Mipot-Hi-Tech/mip_servo_controller/production/BOM_PCBWay.xlsx

 |  |  | LoRa based triple stepper board PCS BOM
Item # | *Designator | *Qty | Manufacturer | *Mfg Part # | Description / Value | *Package/Footprint | Type | ORDER CODE(MOUSER)
1 | C1,C17,C32,C47,C53,C57,C67 | 7 | MURATA | GRM21BR71C475KE51L | Multilayer Ceramic Capacitors MLCC - SMD/SMT 4.7 uF 16 VDC 10% 0805 X7R | C0805 | SMD | 81-GRM21BR71C475KE1L
2 | C2,C3,C6,C7,C19,C21,C22,C34,C36,C37,C49,C50,C51,C52,C55,C58,C59,C60,C61,C63,C64,C65,C68,C69,C70,C71,C72,C73,C74,C75 | 30 | SAMSUNG | CL10B104KC8NNNC | Multilayer Ceramic Capacitors MLCC - SMD/SMT 100nF+/-10% 100V X7R 0603 | C0603 | SMD | 187-CL10B104KC8NNNC
3 | C5,C20,C35 | 3 | TDK | C1608X7R1H223K080AA | Multilayer Ceramic Capacitors MLCC - SMD/SMT 0603 50VDC 22nF 10% X7R 0.8mm | C0603 | SMD | 810-C1608X7R1H223K
4 | C8,C23,C38,C54 | 4 | MURATA | GRM31CZ72A475KE11L | Multilayer Ceramic Capacitors MLCC - SMD/SMT 4.7 uF 100 VDC 10% 1206 X7R | C1206 | SMD | 81-GRM31CZ72A475K11L
5 | C9,C24,C39 | 3 | YAGEO | C0603C221J5GACAUTO7411 | Multilayer Ceramic Capacitors MLCC - SMD/SMT 50V 220pF C0G 0603 5% AEC-Q200 | C0603 | SMD | 667-EEU-FR1J151
6 | C18,C33,CC48 | 3 | SAMSUNG | CL10B474KA8NNNC | Multilayer Ceramic Capacitors MLCC - SMD/SMT 470nF+/-10% 25V X7R 0603 | C0603 | SMD | 187-CL10B474KA8NNNC
7 | C56 | 1 | KEMET | C0603C221J5GACAUTO7411 | Multilayer Ceramic Capacitors MLCC - SMD/SMT 50V 220pF C0G 0603 5% AEC-Q200 | C0603 | SMD | 80-C0603C221J5GAUTLR
8 | D1 | 1 | NEXPERIA | BZT52-C13J | Zener Diodes BZT52-C13/SOD123/SOD2 | SOD-123-2 | SMD | 771-BZT52-C13J
9 | F1 | 1 | LITTLEFUSE | MICROSMD050F-2 | Resettable Fuses - PPTC .5A 13.2V 40A Imax | 1210 | SMD | 650-MICROSMD050F-2
10 | F3 | 1 | BOURNS | SF-1206HH1200R-2 | Surface Mount Fuses 1206 high-current met-foil. 12A | 1206 | SMD | SF-1206HH1200R-2
11 | FB1,FB2,FB4 | 3 | WURTH ELEKTRONIK | 742792030 | Ferrite Beads WE-CBF 3mOhms 10K mA805 AEC-Q200 | 0805 | SMD | 710-742792030
12 | J3,J5,J7 | 3 | PHOENIX CONTACT | 1755752 | Pluggable Terminal Blocks 4 Pos 5.08mm pitch Through Hole Header | Pitch 5.08mm | THT | 651-1755752
13 | J4 | 1 | MOLEX | 73412-0110 | RF Connectors / Coaxial Connectors MCX V PCB JACK SMT 1.25MM MNT HGT |  | SMD | 538-73412-0110
14 | J9 | 1 | GCT | USB4105-GF-A | USB Connectors USB Type C,2.0, Rec,SMT, 0.95mmTH Shell Stakes,G/F,RA,Top Mnt,T&R |  | SMD | 640-USB4105-GF-A
15 | J10 | 1 | PHOENIX CONTACT | 1987096 | Fixed Terminal Blocks MKDSN 2,5/ 2-5,08 SZS-SCREW | Pitch 5.08mm | SMD | 651-1987096
16 | J15,J16,J17 | 3 | PHOENIX CONTACT | 1792265 | Pluggable Terminal Blocks 4 Pos 5.08mm pitch Plug 24-12 AWG Screw |  |  | 651-1792265
17 | L1 | 1 | TAIYO YUDEN | NRS6028T470MMGJ | Power Inductors - SMD 963-LSXND6060WHL470M RPLCMT PN 6028 47uH 390mOhms |  | SMD | 963-NRS6028T470MMGJ
18 | M1 | 1 | MIPOT | 32001505/6CEU | 32001506BEU - MIPOT DUAL CORE LoRa MODULE | LGA | SMD | https://mipot.com/en/products/mip-series/dual-core/32001506deu/
19 | MOT1,MOT2,MOT3 | 3 | ANALOG DEVICES | TMC2130-LA | Motor/Motion/Ignition Controllers & Drivers Silent stepper motor driver 5 to 46V, up to 1.2A with S/D and SPI Interface, 256 Steps, CoolStep, StallGuard and StealthChop |  | SMD | 700-TMC2130LA
20 | Q1 | 1 | DIODES INCORPORATED | DMPH6050SK3-13 | MOSFETs MOSFET BVDSS | DPAK-3 | SMD | 621-DMPH6050SK3-13
21 | Q2,Q3 | 2 | DIODES INCORPORATED | BS870-7-F | MOSFETs 60V 310mW | SOT-23-3 | SMD | 621-BS870-F
22 | R2,R3,R4,R5,R6,R8,R9,R10,R14,R15,R16,R17,R20,R26,R27,R32,R33,R34,R35,R38,R44,R45,R50,R51,R52,R53,R56,R62,R63,R69,R70,R71,R72,R83,R84 | 35 | YAGEO | AC0603JR-0722RL | Thick Film Resistors - SMD 22 Ohms 100 mW 0603 5% AEC-Q200 Standard Power Version | R0603 | SMD | 603-AC0603JR-0722RL
23 | R7,R74,R88 | 3 | YAGEO | RT0603FRE07360KL | Thick Film Resistors - SMD 360k Ohms 100 mW 0603 5% AEC-Q200 Standard Power Version | R0603 | SMD | 603-RT0603FRE07360KL
24 | R11,R12,R13,R18,R19,R23,R25,R31,R36,R37,R41,R43,R49,R54,R55,R59,R61 | 17 | YAGEO | RC0603FR-100RL | Thick Film Resistors - SMD 0 Ohms 100-200mW 0603 1% | R0603 | SMD | 603-RC0603FR-100RL
25 | R21,R22,R39,R40,R57,R58,R87,R89 | 8 | YAGEO | RC0603JR-0710KL | Thick Film Resistors - SMD 10 kOhms 100 mW 0603 5% | R0603 | SMD | 603-RC0603JR-0710KL
26 | R28,R29,R46,R47,R64,R65 | 6 | YAGEO | RL1206FR-070R22L | Current Sense Resistors - SMD 220 mOhms 250mW 1 % 600 ppm/C | R1206 | SMD | 603-RL1206FR070R22L
27 | R30,R48,R66 | 3 | YAGEO | RC0603JR-072R2L | Thick Film Resistors - SMD 2.2 Ohms 100 mW 0603 5% | R0603 | SMD | 603-RC0603JR-072R2L
28 | R67,R68 | 2 | YAGEO | RC0603FR-105K1L | Thick Film Resistors - SMD 5.1kOhms 1/10W 0603 1% | R0603 | SMD | 603-RC0603FR-105K1L
29 | R73,R76 | 2 | YAGEO | RC0402FR-0756K2L | Thick Film Resistors - SMD 56.2 kOhms 62.5mW 0402 1% | R0402 | SMD | 603-RC0402FR-0756K2L
30 | R75 | 1 | YAGEO | RC0603FR-071ML | Thick Film Resistors - SMD 1 MOhms 100mW 0603 1% | R0603 | SMD | 603-RC0603FR-071ML
31 | R85 | 1 | YAGEO | RC0402FR-0718KL | Thick Film Resistors - SMD 18 kOhms 62.5mW 0402 1% | R0402 | SMD | 603-RC0402FR-0718KL
32 | R86 | 1 | YAGEO | RC0402FR-0756K2L | Thick Film Resistors - SMD 56.2 kOhms 62.5mW 0402 1% | R0603 | SMD | 603-RC0402FR-0756K2L
33 | U2 | 1 | FTDI | FT230XQ-R | USB Interface IC USB to Basic Serial UART IC QFN-16 | QFN16 | SMD | 895-FT230XQ-R
34 | U3 | 1 | STMICROELECTRONICS | USBLC6-2SC6 | ESD Protection Diodes / TVS Diodes ESD Protection Low Cap | SOT23-6 | SMD | 511-USBLC6-2SC6
35 | U4 | 1 | TEXAS INSTRUMENTS | LMR51610XDBVR | Switching Voltage Regulators SIMPLE SWITCHER power converter with 4.5V-to-65V 1A synchronous buck and 25uA quiescent current 6-SOT-23 -40 to 150 | SOT23-6 | SMD | 595-LMR51610XDBVR
36 | U6 | 1 | TEXAS INSTRUMENTS | TXS0102DCUR | Translation - Voltage Levels 2-Bit Bi-Directional Voltage-Level-Trans | VSSOP-8 | SMD | 595-TXS0102DCUR
37 | U7 | 1 | DIODES INCORPORATED | AP2127K-ADJTRG1 | LDO Voltage Regulators 300mA CMOS LDO 2.5V to 6V | SOT23-5 | SMD | 621-AP2127K-ADJTRG1
38 | U8,U9 | 2 | MICROCHIP | MCP6001T-E/OT | Operational Amplifiers - Op Amps Single 1.8V 1MHz | SOT23-5 | SMD | 579-MCP6001T-E/OT
