Mipot-Hi-Tech/mip_servo_controller/firmware/mip_trinamic/Core/Inc/app_diagnosis.h

#ifndef CORE_INC_APP_DIAGNOSIS_H_
#define CORE_INC_APP_DIAGNOSIS_H_

/*******************************************************************************
 * Included files
 *****************************************************************************/

/*******************************************************************************
 * Definitions
 ******************************************************************************/

/*******************************************************************************
* API
******************************************************************************/
void vTaskStepperDiagnosis(void);

#endif
