Mipot-Hi-Tech/mip_servo_controller/(commit log)

2025-03-13 modified direction control for stepper
2025-05-05 ipcc stuck in eeprom write cmd. now ok
    [ipcc.c, main.c, mip_a.c, mip_a.h, mip_a_def.h, mip_b.c, mip_b.h, mip_b_def.h]
2025-09-25 TIM2 now handles also servos
